Zaion-BM/Temalabor/README.md

# Témalabor
University project at BME-VIK-MIT
