Zaion-BM/Temalabor/neslab_prezi_hpd5lb.pptx

## Logikai analizátor mikrovezérlővel

Berta Máté
Naszály Gábor

## Feladat

- Logikai analizátor készítése az STK3700 kártya felhasználásával
  - 4 csatorna
  - Változtatható komparálási feszültség
- A megoldás során elkészül:
  - Kiegészítő NYÁK
  - Szoftver a mikrovezérlőre
  - Szoftver PC-re

## Rendszerterv

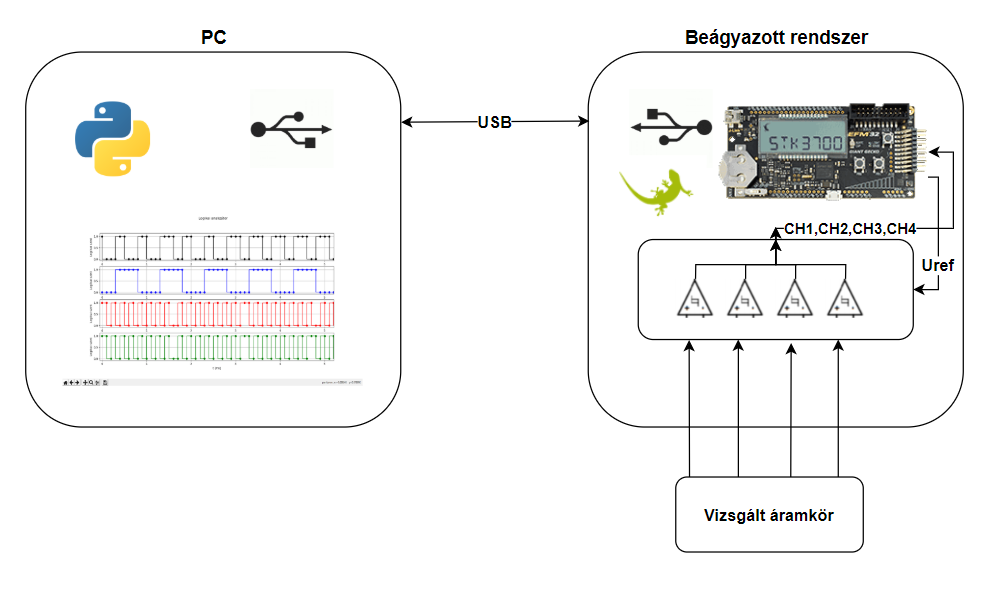
[picture p1: figure]

## Kapcsolási rajz 1.

Schmitt trigger:

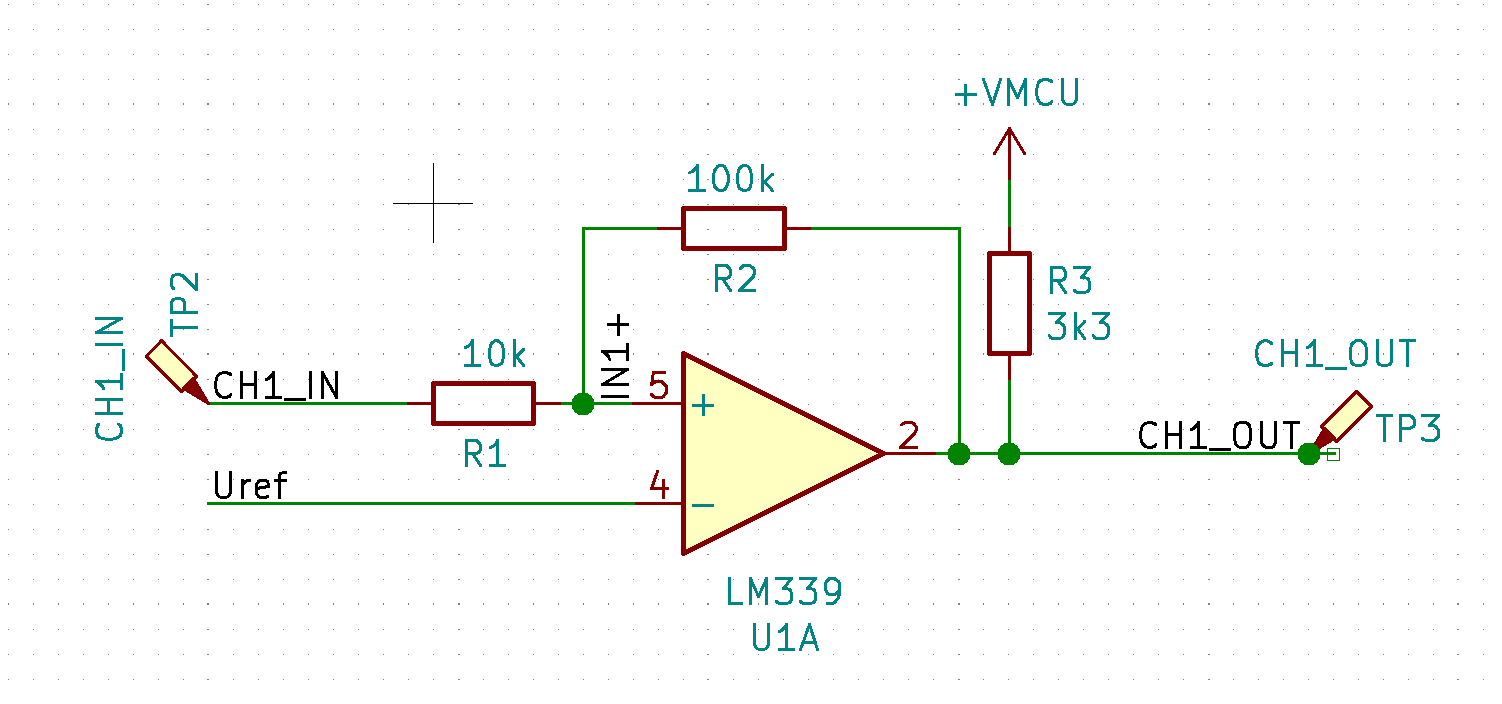
[picture p2: figure]

## LTspice szimuláció

- U_(komparálás) =(1+ (R1)/(R2))∙U_(ref) −(R1)/(R2)∙U_(logikai szint)

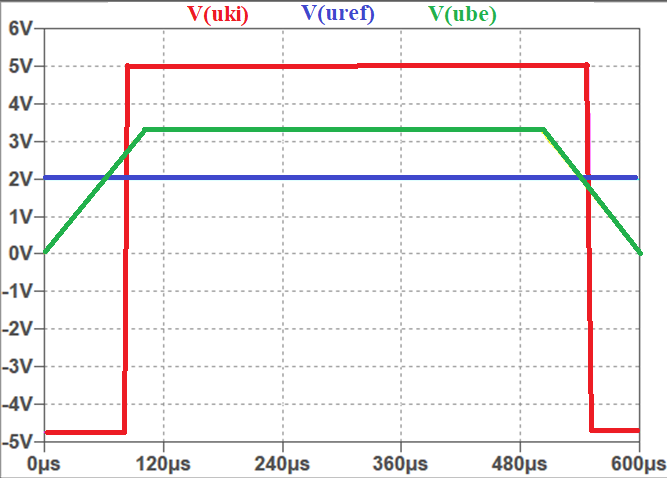
[picture p3: figure]
A képen szöveg, térkép látható Automatikusan generált leírás

## Kapcsolási rajz 2.

Túlfeszültség elleni védelem:

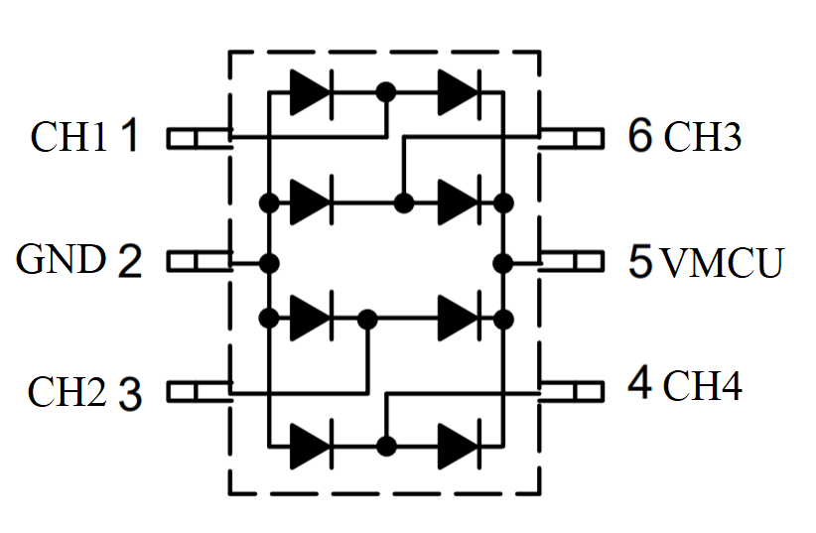
[picture p4: figure]

## PCB layout

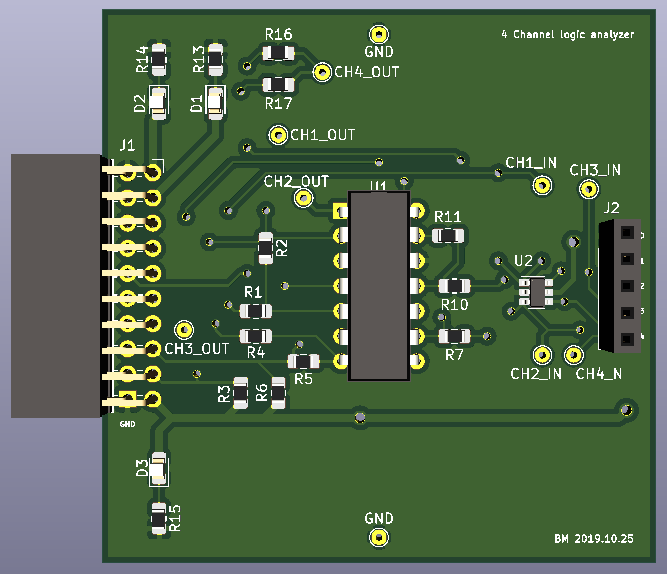
[picture p5: figure]
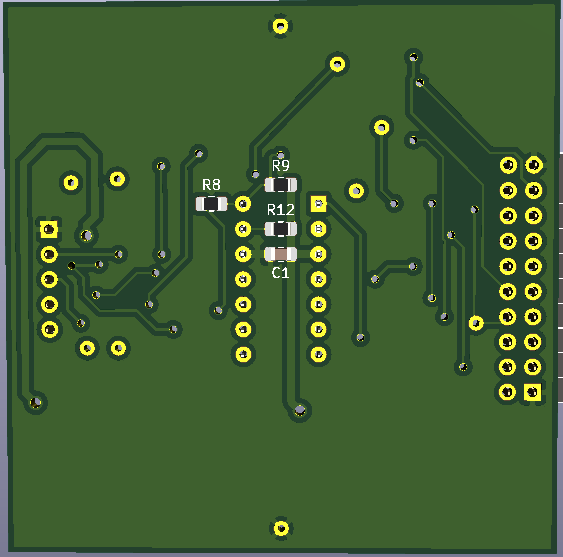
[picture p6: figure]

## Szoftver komponensek

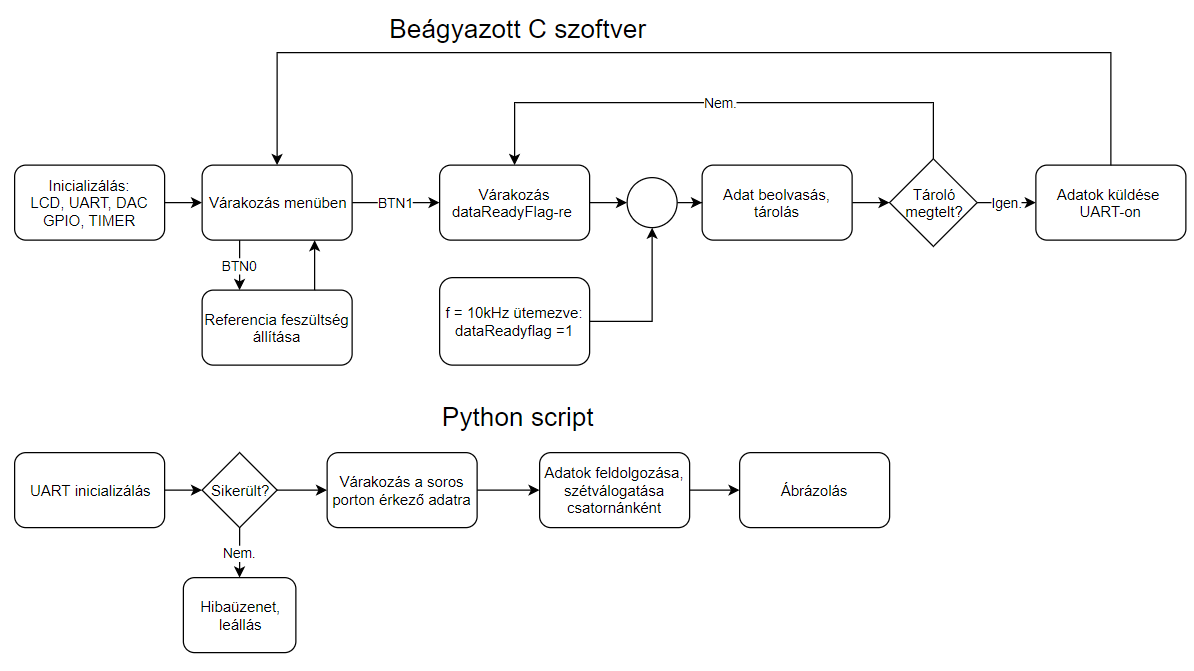
[picture p7: figure]

## Hullámforma

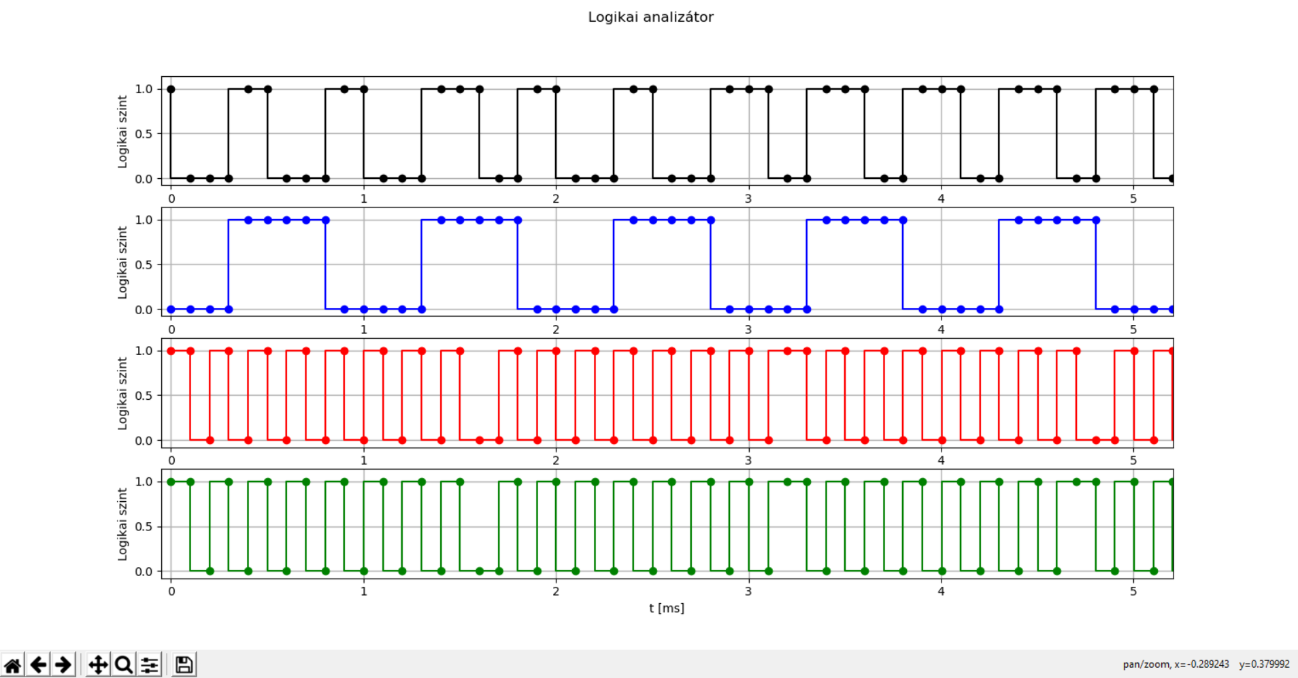
[picture p8: figure]

## Projekt „demonstráció”

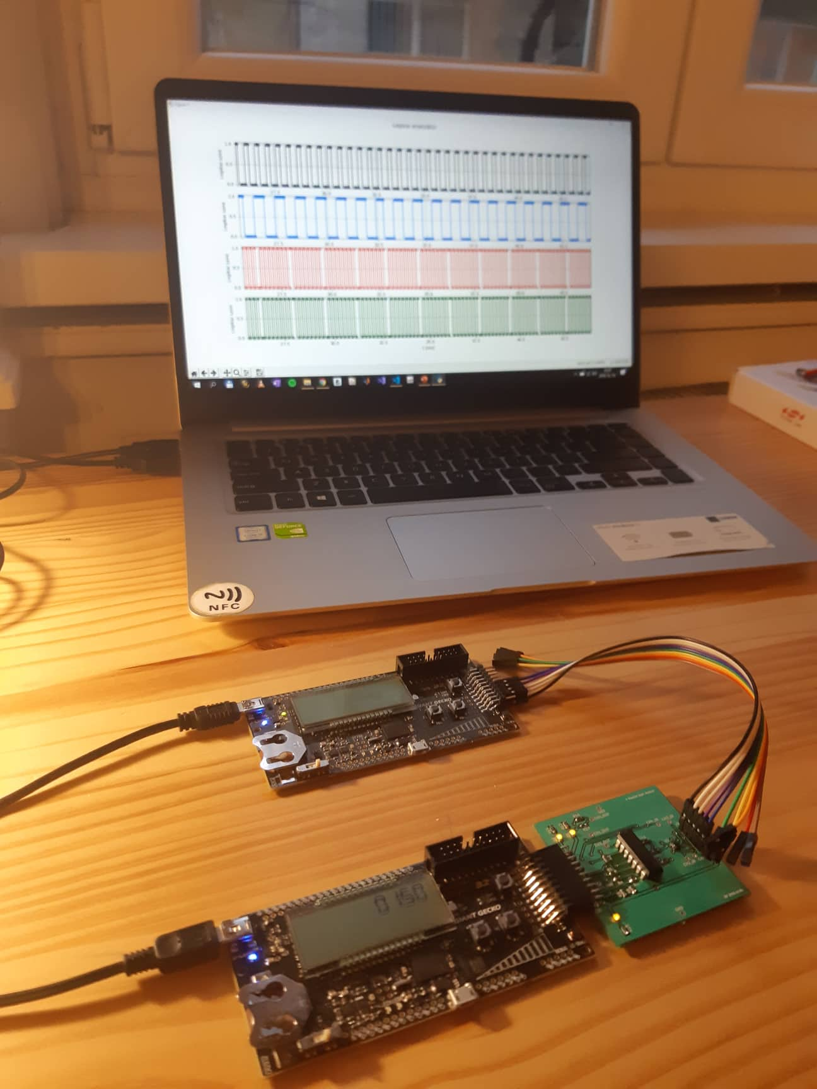
[picture p9: figure]
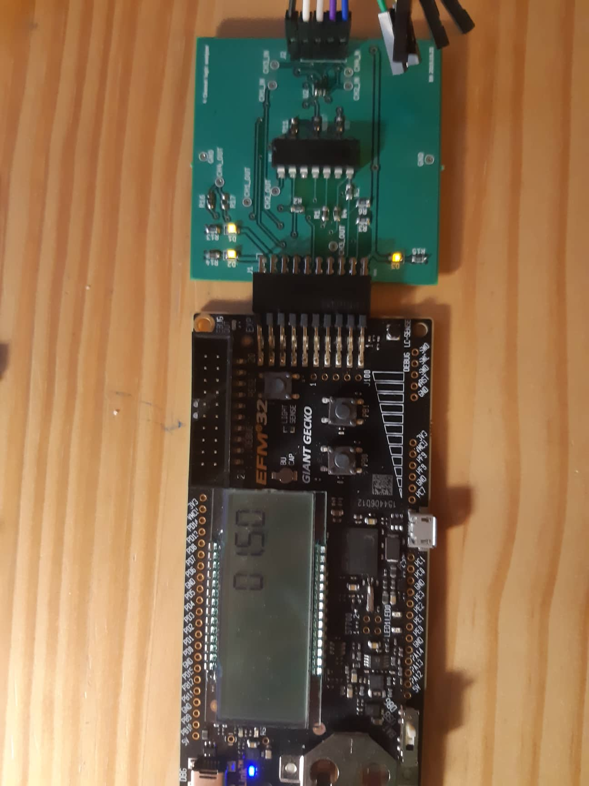
[picture p10: figure]
A képen elektronika, áramkör, asztal, ülő látható Automatikusan generált leírás

## Fejleszthetőség

- További trigger funkciók hozzáadása
- Állapot vizsgálat funkciója
- Folytonos megjelenítés
