Zaion-BM/Temalabor/KiCAD project/layout_pdfs/temalab_comparator-B_Cu.pdf

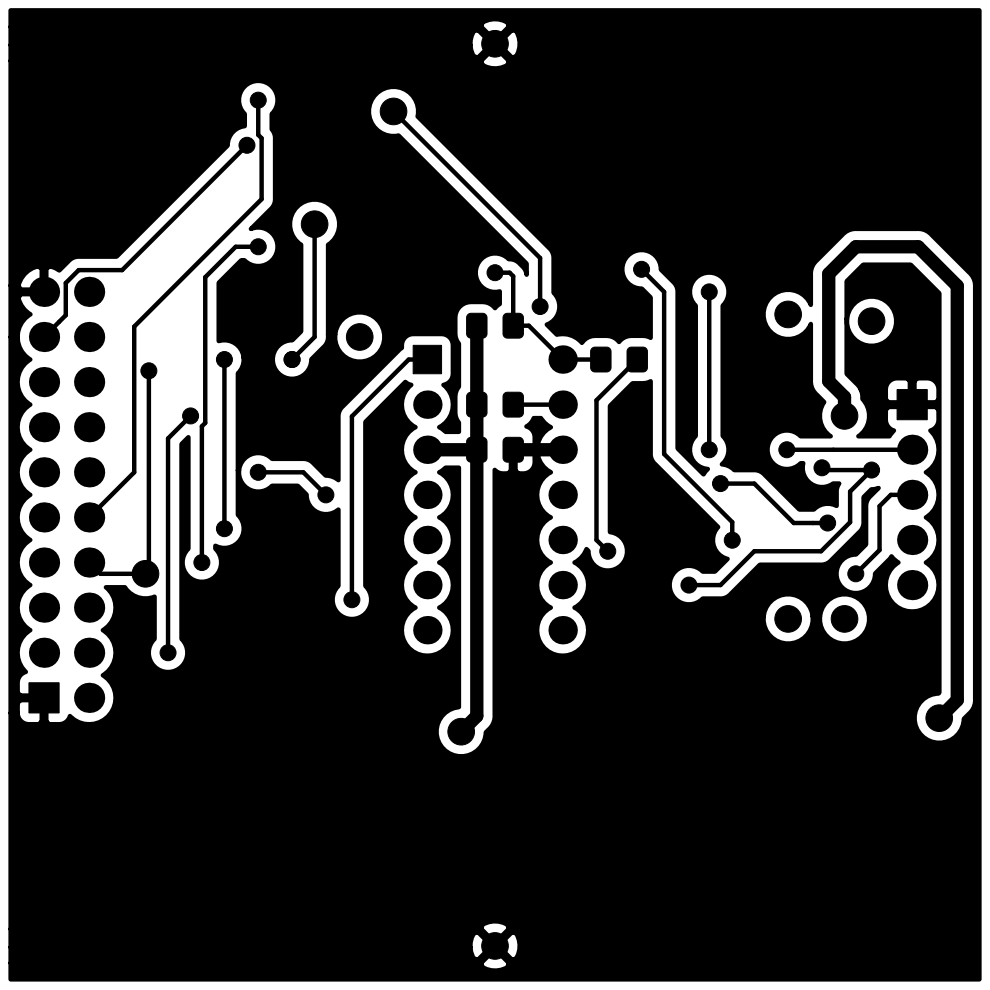
[picture p19: page 1]
