Zaion-BM/Temalabor/KiCAD project/layout_pdfs/temalab_comparator-B_Mask.pdf

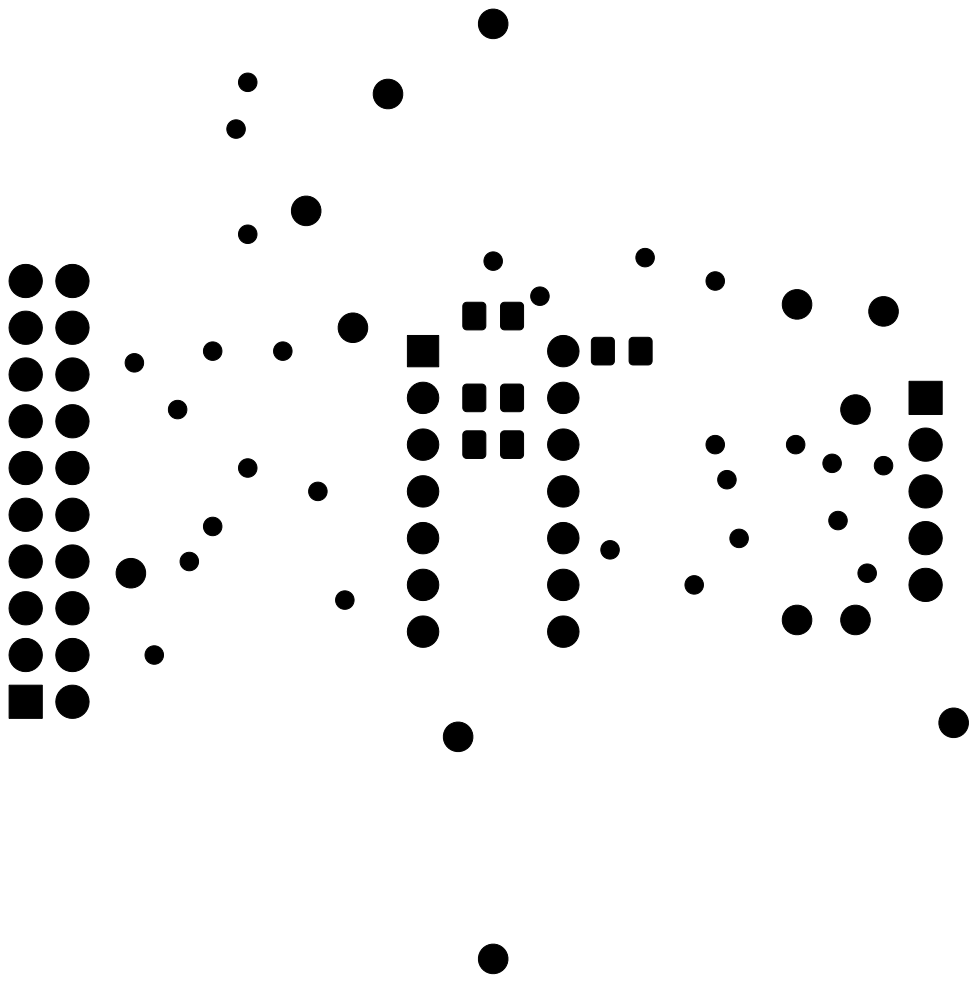
[picture p20: page 1]
