Zaion-BM/Temalabor/KiCAD project/layout_pdfs/temalab_comparator-B_SilkS.pdf

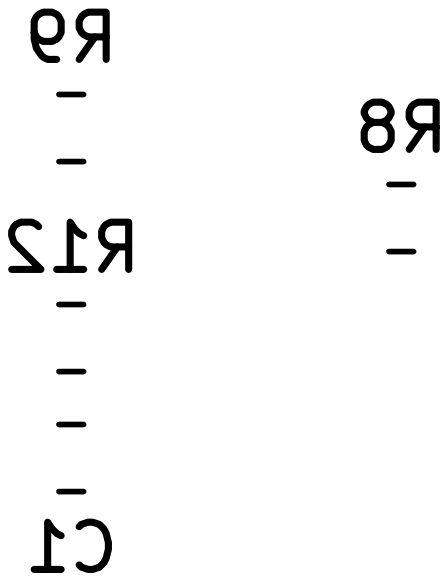
[picture p21: page 1]
