Zaion-BM/Temalabor/KiCAD project/layout_pdfs/temalab_comparator-F_Cu.pdf

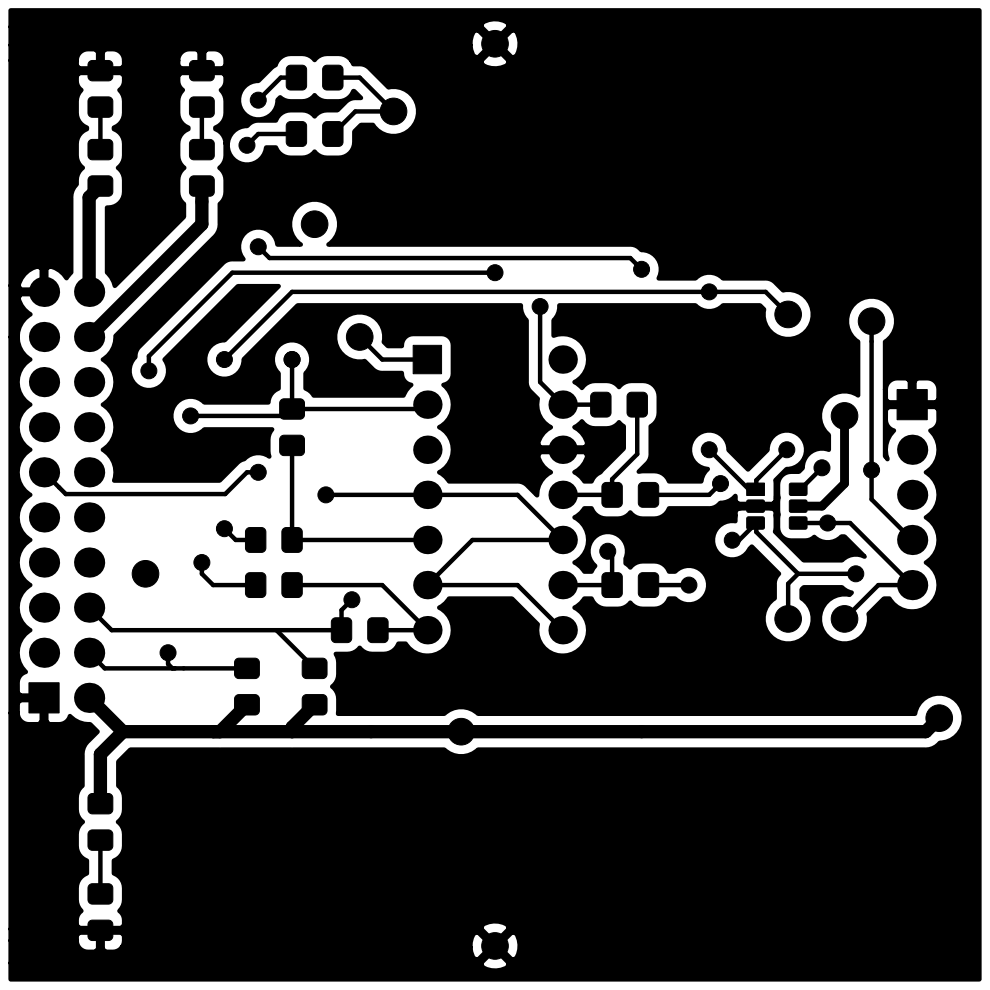
[picture p22: page 1]
