Zaion-BM/Temalabor/KiCAD project/layout_pdfs/temalab_comparator-F_Mask.pdf

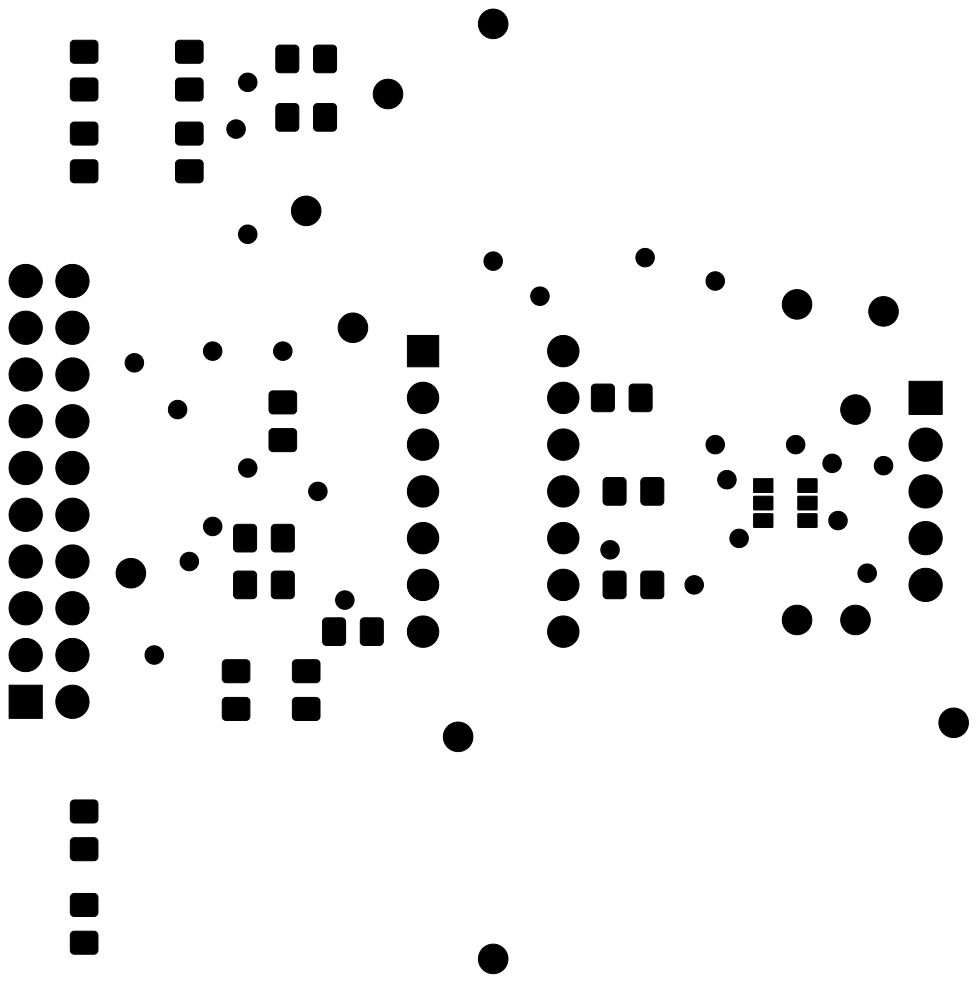
[picture p23: page 1]
