Zaion-BM/Temalabor/KiCAD project/layout_pdfs/temalab_comparator-F_SilkS.pdf

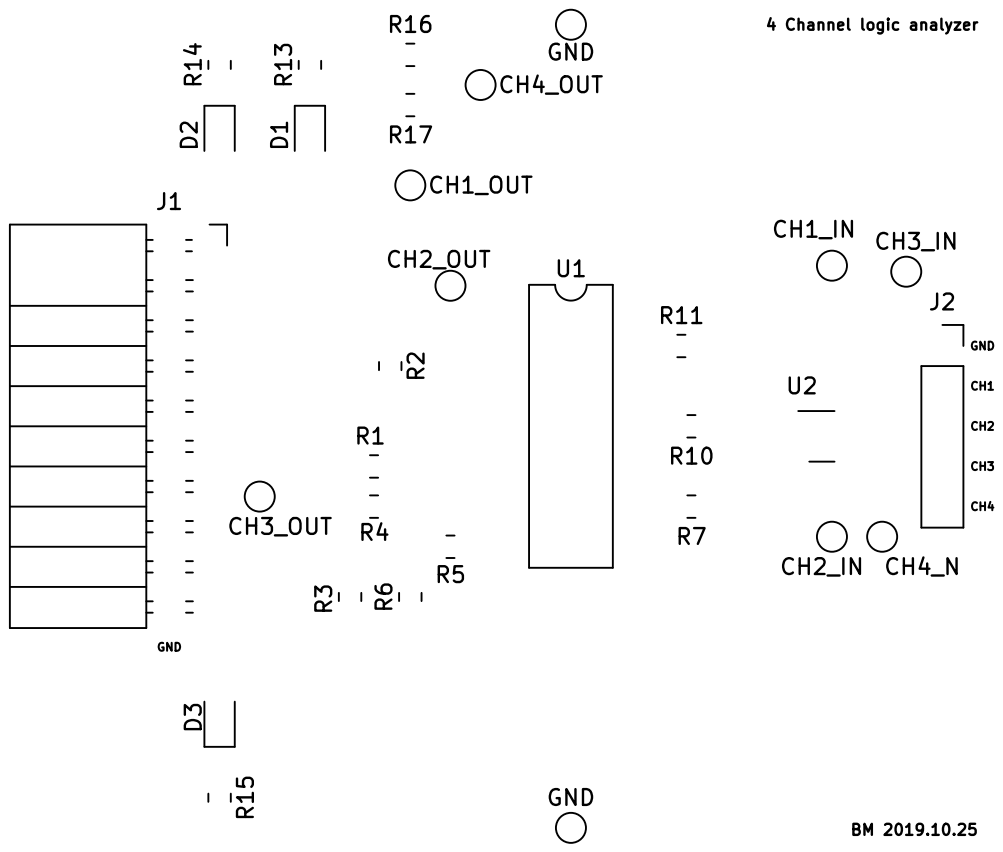
[picture p24: page 1]
