Zaion-BM/Temalabor/KiCAD project/temalab_comparator.kicad_pcb

## KiCad design KiCAD project/temalab_comparator.kicad_pcb (2020-12-06)

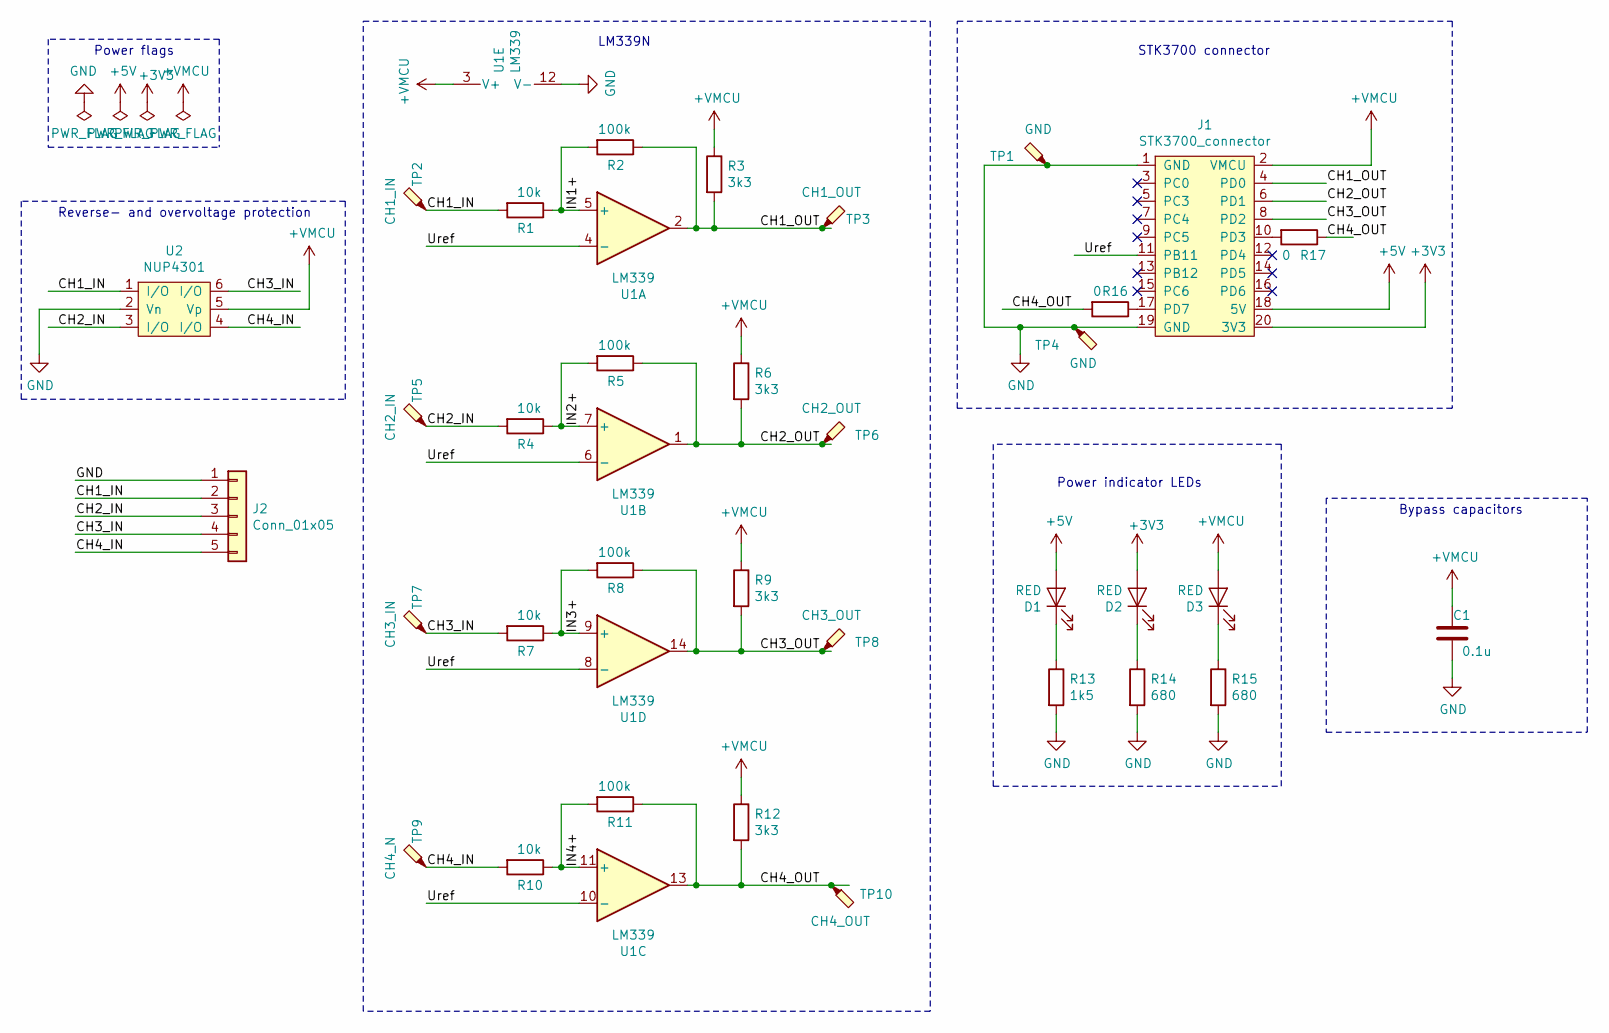
[picture p25: schematic temalab_comparator.sch]

Parts:
C1: 0.1u; C_0805_2012Metric_Pad1.15x1.40mm_HandSolder
D1, D2, D3: RED; LED_0805_2012Metric_Pad1.15x1.40mm_HandSolder
J1: STK3700_connector; PinSocket_2x10_P2.54mm_Horizontal_STK3700
J2: Conn_01x05; PinSocket_1x05_P2.54mm_Vertical
R1, R4, R7, R10: 10k; R_0805_2012Metric_Pad1.15x1.40mm_HandSolder
R2, R5, R8, R11: 100k; R_0805_2012Metric_Pad1.15x1.40mm_HandSolder
R3, R6, R9, R12: 3k3; R_0805_2012Metric_Pad1.15x1.40mm_HandSolder
R13: 1k5; R_0805_2012Metric_Pad1.15x1.40mm_HandSolder
R14, R15: 680; R_0805_2012Metric_Pad1.15x1.40mm_HandSolder
R16, R17: 0; R_0805_2012Metric_Pad1.15x1.40mm_HandSolder
TP1, TP4: GND; TestPoint_THTPad_D1.5mm_Drill0.7mm_Value_on_Silk_Screen
TP2: CH1_IN; TestPoint_THTPad_D1.5mm_Drill0.7mm_Value_on_Silk_Screen
TP3: CH1_OUT; TestPoint_THTPad_D1.5mm_Drill0.7mm_Value_on_Silk_Screen
TP5: CH2_IN; TestPoint_THTPad_D1.5mm_Drill0.7mm_Value_on_Silk_Screen
TP6: CH2_OUT; TestPoint_THTPad_D1.5mm_Drill0.7mm_Value_on_Silk_Screen
TP7: CH3_IN; TestPoint_THTPad_D1.5mm_Drill0.7mm_Value_on_Silk_Screen
TP8: CH3_OUT; TestPoint_THTPad_D1.5mm_Drill0.7mm_Value_on_Silk_Screen
TP9: CH4_N; TestPoint_THTPad_D1.5mm_Drill0.7mm_Value_on_Silk_Screen
TP10: CH4_OUT; TestPoint_THTPad_D1.5mm_Drill0.7mm_Value_on_Silk_Screen
U1: LM339; DIP-14_W7.62mm_LM339n
U2: NUP4301; TSOP-6_1.65x3.05mm_P0.95mm_NUP4301

Connections:
+3V3: D2.2 (A), J1.20 (3V3)
+5V: D1.2 (A), J1.18 (5V)
/CH1_IN: J2.2, R1.2, TP2.1, U2.1 (I/O)
/CH1_OUT: J1.4 (PD0), R2.1, R3.2, TP3.1, U1.2
/CH2_IN: J2.3, R4.2, TP5.1, U2.3 (I/O)
/CH2_OUT: J1.6 (PD1), R5.1, R6.2, TP6.1, U1.1
/CH3_IN: J2.4, R7.2, TP7.1, U2.6 (I/O)
/CH3_OUT: J1.8 (PD2), R8.1, R9.2, TP8.1, U1.14
/CH4_IN: J2.5, R10.2, TP9.1, U2.4 (I/O)
/CH4_OUT: R11.1, R12.2, R16.2, R17.1, TP10.1, U1.13
/IN1+: R1.1, R2.2, U1.5 (+)
/IN2+: R4.1, R5.2, U1.7 (+)
/IN3+: R7.1, R8.2, U1.9 (+)
/IN4+: R10.1, R11.2, U1.11 (+)
/Uref: J1.11 (PB11), U1.4 (-), U1.6 (-), U1.8 (-), U1.10 (-)
GND: C1.1, J1.1 (GND), J1.19 (GND), J2.1, R13.2, R14.2, R15.2, TP1.1, TP4.1, U1.12 (V-), U2.2 (Vn)
unnamed: D1.1 (K), R13.1
unnamed: D2.1 (K), R14.1
unnamed: D3.1 (K), R15.1
unnamed: J1.10 (PD3), R17.2
unnamed: J1.17 (PD7), R16.1
VMCU: C1.2, D3.2 (A), J1.2 (VMCU), R3.1, R6.1, R9.1, R12.1, U1.3 (V+), U2.5 (Vp)

Notes on the sheet:
STK3700 connector
Power indicator LEDs
Power flags
Bypass capacitors
Reverse- and overvoltage protection
LM339N

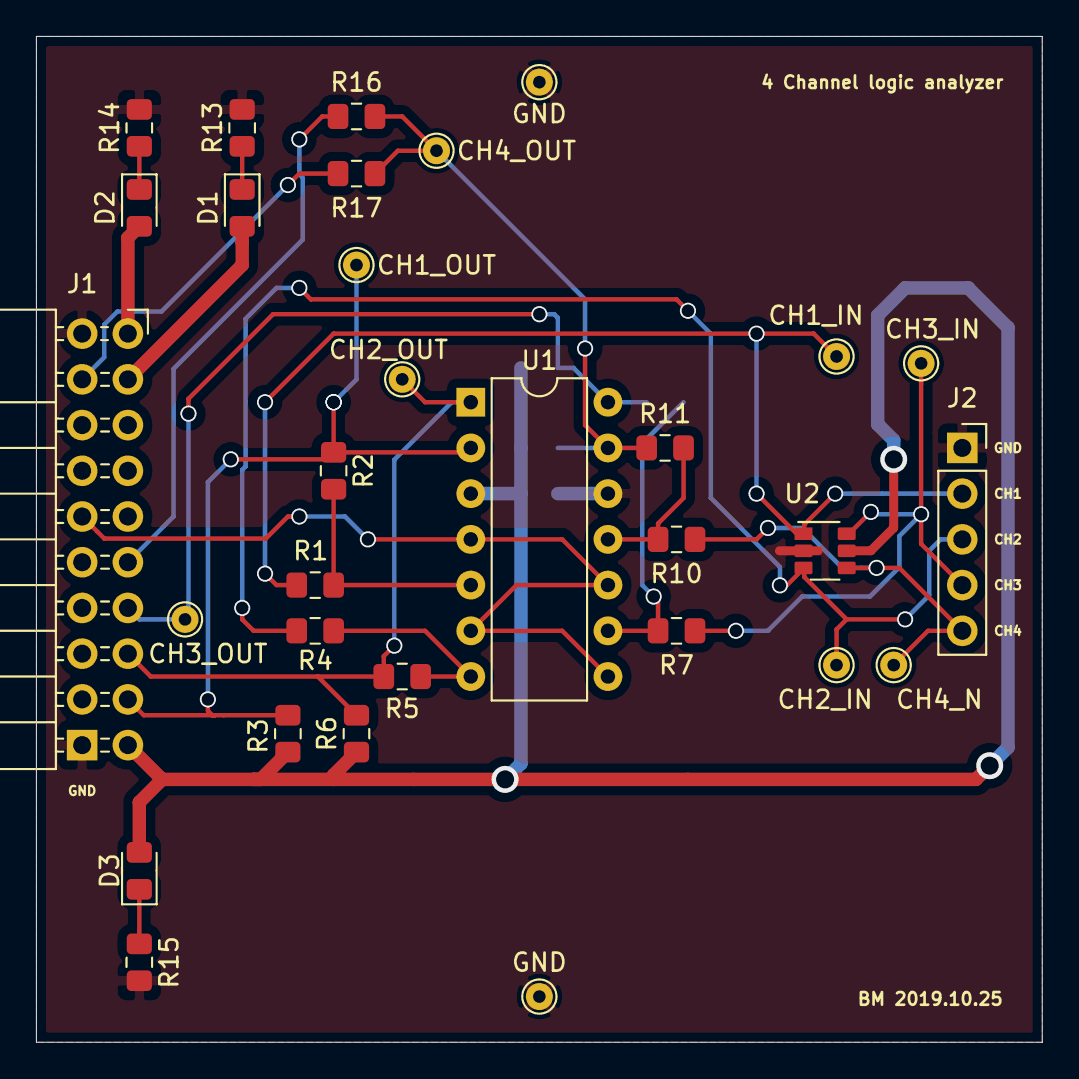
[picture p26: board temalab_comparator.kicad_pcb from above]

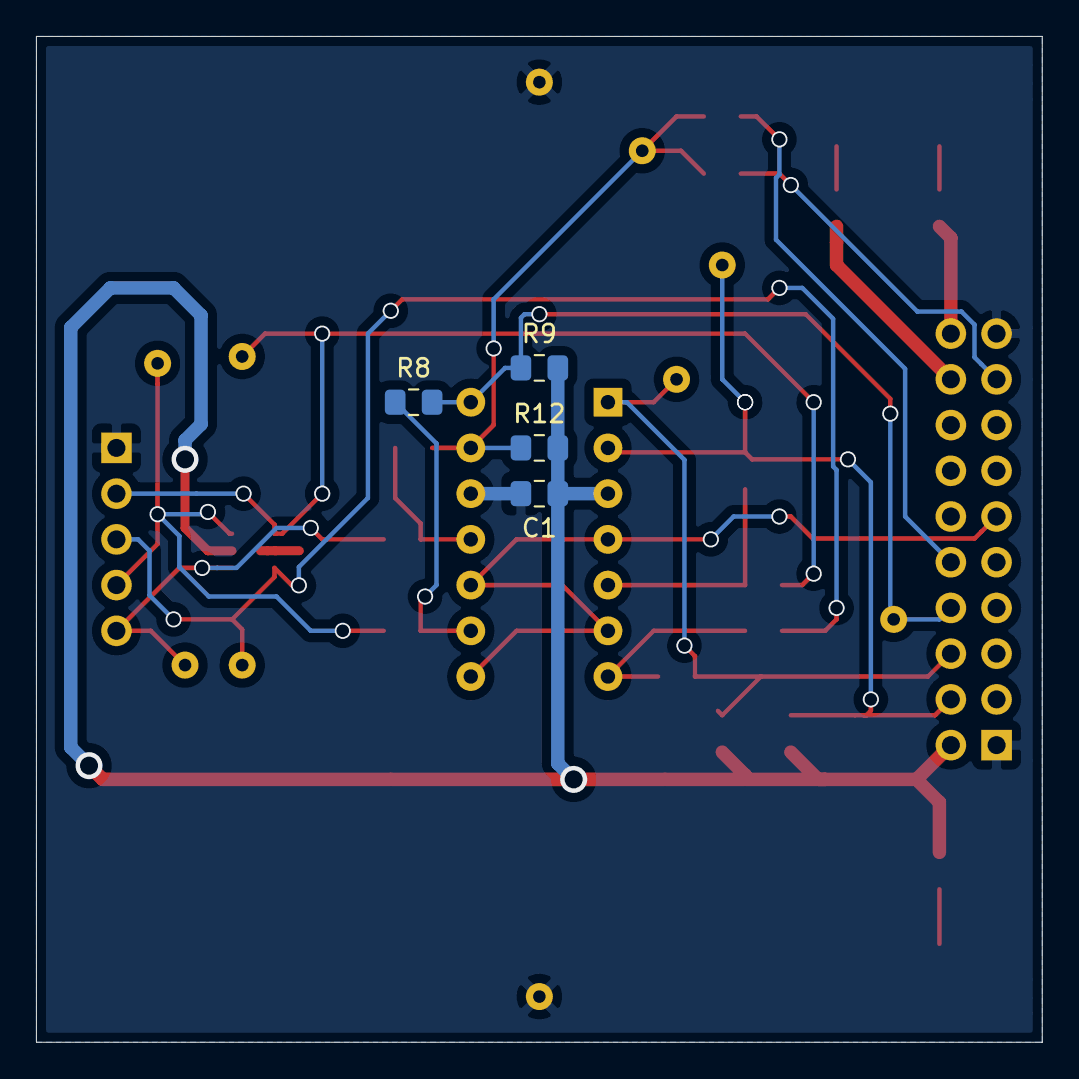
[picture p27: board temalab_comparator.kicad_pcb from below]

Board: 2 copper layers, 55.9 x 55.9 mm, 35 parts (4 on the bottom side), 22 nets.
