Zaion-BM/Temalabor/(commit log)

2020-12-06 Schematic & PCB project
    Went to production
    [temalab_comparator-B_Cu.gbr, temalab_comparator-B_Mask.gbr, temalab_comparator-B_SilkS.gbr, temalab_comparator-Edge_Cuts.gbr, temalab_comparator-F_Cu.gbr, temalab_comparator-F_Mask.gbr, temalab_comparator-F_SilkS.gbr, temalab_comparator-NPTH.drl]
2020-12-06 Schematic & PCB
    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
    [temalab_comparator-B_Cu.gbr, temalab_comparator-B_Mask.gbr, temalab_comparator-B_SilkS.gbr, temalab_comparator-Edge_Cuts.gbr, temalab_comparator-F_Cu.gbr, temalab_comparator-F_Mask.gbr, temalab_comparator-F_SilkS.gbr, temalab_comparator-NPTH.drl]
